gsaurabhr/watchy-sports-hardware/README.md

# watchy-hardware
Watchy Hardware CAD Files
