gsaurabhr/watchy-sports-hardware/watchy-sports-lcsc-jlcpcb-bom.xlsx

Reference | Quantity | Value | Footprint | LCSC | MPN | LCSC Alt | Manufacturer_Name | Mouser Part Number
C1 C2 C4 C5 C8 C10 C11 C13 C14 | 9 | 100nF | Capacitor_SMD:C_0603_1608Metric
C12 | 1 | 4.7uF/50V | Capacitors_SMD:C_0805
C3 | 1 | 1uF | Capacitor_SMD:C_0603_1608Metric
C6 C7 | 2 | 220nF | Capacitor_SMD:C_0603_1608Metric
C9 | 1 | 10uF/50V | Capacitor_SMD:C_0805_2012Metric
D4 | 1 | MBR0530 | Diodes_SMD:D_SOD-123 | C77336 | MBR0530
D5 | 1 | LED | LEDs:LED_0603 | C2286 | LTST-C190KRKT
D6 | 1 | 1N4001 | Diodes_SMD:D_SOD-123F | C433392 | 1N4001
IC1 | 1 | L76L-M33 | Watchy:L76 | C2649477 | L76L-M33 | C90770 | Quectel | 277-L76-M33
J1 | 1 | 503480-0400 | Watchy:MOLEX_503480-0400 | C563965 | 503480-0400 |  | Molex, LLC
J2 | 1 | Micro USB | Watchy:USB_Micro-B | C91146 | U-F-M5DD-Y-L | C145792
J3 | 1 | Battery | Watchy:1.25T-2PWT (Molex 532610271) | C189700 | 532610271
J4 | 1 | FH33-10S-0.5SH(10) | Watchy:FH3310S05SH10 |  | FH33-10S-0.5SH(10) |  | Hirose | 798-FH3310S0.5SH10
J5 | 1 | U.FL-R-SMT(01) | Watchy:HRS_U.FL-R-SMT(01) | C88374 | U.FL-R-SMT(01) |  | Hirose
Q2 | 1 | UMH3N | TO_SOT_Packages_SMD:SOT-363_SC-70-6 | C62892 | UMH3N
Q4 | 1 | CJ2301 | TO_SOT_Packages_SMD:SOT-23 | C8547 | CJ2301
Q5 | 1 | S8050 | TO_SOT_Packages_SMD:SOT-23 | C2146 | S8050
R1 R4 R5 R6 R7 R9 R10 R14 R15 | 9 | 10K | Resistor_SMD:R_0402_1005Metric
R12 R13 | 2 | 100K | Resistor_SMD:R_0402_1005Metric
R16 R17 | 2 | 1K | Resistor_SMD:R_0402_1005Metric
R2 R3 | 2 | 4.7K | Resistor_SMD:R_0402_1005Metric
R8 | 1 | 3.5K | Resistor_SMD:R_0402_1005Metric
SW1 SW2 SW3 SW4 | 4 | BTN | Watchy:K2-1114SA-A4SW-06 | C136662 | K2-1114SA-A4SW-06
U1 | 1 | ESP32-PICO-D4 | Housings_DFN_QFN:QFN-48-1EP_7x7mm_Pitch0.5mm | C193707 | ESP32-PICO-D4
U10 | 1 | BME280 | Package_LGA:Bosch_LGA-8_2.5x2.5mm_P0.65mm_ClockwisePinNumbering | C92489 | BME280
U2 | 1 | ME6211C33M5G-N | TO_SOT_Packages_SMD:SOT-23-5 | C82942 | ME6211C33M5G-N
U3 | 1 | CP2104 | Housings_DFN_QFN:QFN-24-1EP_4x4mm_Pitch0.5mm | C430013 | CP2104-F03-GM
U4 | 1 | BMA423 | Housings_LGA:LGA-12_2x2mm_Pitch0.5mm | C189517 | BMA423 |  | Bosch Sensortec
U5 | 1 | TP4054 | TO_SOT_Packages_SMD:SOT-23-5 | C32574 | TP4054
U6 | 1 | CAT4004AHU2-GT3 | Watchy:CAT4004AHU2-GT3 | C184239 | CAT4004AHU2-GT3
U7 | 1 | MX25L25645GZN-10G | Package_SON:WSON-8-1EP_6x5mm_P1.27mm_EP3.4x4mm | C2802981 | MX25L25645GZN-10G
U8 | 1 | LTR-303ALS-01 | OptoDevice:Lite-On_LTR-303ALS-01 | C364577 | LTR-303ALS-01
U9 | 1 | IIS2MDCTR | Watchy:IIS2MDCTR | C2655002 | IIS2MDCTR
Y1 | 1 | RV-8523-C3-TA-QC-020 | Watchy:RV8523C3TAQC020 |  | RV-8523-C3-TA-QC-020 |  | Micro Crystal AG | N/A
