gsaurabhr/watchy-sports-hardware/watchy-sports-info.xlsx

Sheet: Pin map
ESP32 GPIO | Input | Output | Notes | Buttons | BMA423 | BME280 | Analog / Battery | LCD | IIS2MDC | VIB | Flash memory | RV-8523-C3 | GPS | SP32-PICO-D4 | GDEH0154D67 | BMA423 | DS3231 | Battery ADC | UART | Buttons
0 | pulled up | OK | Strapping pin! 1 for SPI, 0 for downloading firmware, RTC
1 | TX | OK | debug output at boot, HIGH on boot |  |  |  |  |  |  |  |  |  |  | GPIO 1 |  |  |  |  | TX
2 | OK | OK | Strapping pin! Must be 0 for downloading firmware, anything for SPI FLASH Boot, RTC |  |  |  |  |  |  | VIB_PWM
3 | OK | RX | HIGH at boot |  |  |  |  |  |  |  |  |  |  | GPIO 3 |  |  |  |  | RX
4 | OK | OK | RTC | Button 4 |  |  |  |  |  |  |  |  |  | GPIO 4 |  |  |  |  |  | Button 4
5 | OK | OK | Strapping pin! Must be pull up at boot, VSPI_CS |  |  |  |  | LCD_CS |  |  |  |  |  | GPIO 5 | CS
6 | x | x | connected to the integrated SPI flash
7 | x | x | connected to the integrated SPI flash
8 | x | x | connected to the integrated SPI flash
9 | OK | OK | U1RXD |  |  |  |  | LCD_EN |  |  |  |  |  | GPIO 9 | RES
10 | OK | OK | U1TXD |  |  |  |  | BL_PWM |  |  |  |  |  | GPIO 10 | DC
11 | x | x | connected to the integrated SPI flash
12 | OK | OK | Strapping pin! MUST BE PULLED DOWN AT BOOT, HSPI_MISO, RTC |  |  |  |  |  |  |  | FLASH_MISO |  |  | GPIO 12 |  | INT2
13 | OK | OK | HSPI_MOSI, RTC |  |  |  |  |  |  |  | FLASH_MOSI |  |  | GPIO 13
14 | OK | OK | outputs PWM signal at boot, HIGH on boot, HSPI_CLK, RTC |  |  |  |  |  |  |  | FLASH_CLK |  |  | GPIO 14 |  | INT1
15 | OK | OK | Strapping pin! Pulled high to output debugging log during boot, HSPI_CS, RTC |  |  |  |  |  |  |  | FLASH_CS
16 | x | x | connected to the integrated SPI flash
17 | x | x | connected to the integrated SPI flash
18 | OK | OK | VSPI_CLK |  |  |  |  | LCD_CLK |  |  |  |  |  | GPIO 18 | SCLK
19 | OK | OK | VSPI_MISO |  |  |  |  |  |  |  |  |  | FORCEON | GPIO 19 | BUSY
21 | OK | OK | SDA |  | SDA | SDA |  |  | SDA |  |  | SDA | SDA | GPIO 21 |  | SDA | SDA
22 | OK | OK | SCL |  | SCL | SCL |  |  | SCL |  |  | SCL | SCL | GPIO 22 |  | SCL | SCL
23 | OK | OK | VSPI_MOSI |  |  |  |  | LCD_MOSI |  |  |  |  |  | GPIO 23 | MOSI
25 | OK | OK | DAC1, RTC |  | INT_ACC1 |  |  |  |  |  |  |  |  | GPIO 25 |  |  |  |  |  | Button 2
26 | OK | OK | DAC2, RTC |  |  |  |  |  |  |  |  | INT_RTC |  | GPIO 26 |  |  |  |  |  | Button 1
27 | OK | OK | RTC | Button 2 |  |  |  |  |  |  |  |  |  | GPIO 27 |  |  | INT
32 | OK | OK | ADC1, RTC | Button 3 |  |  |  |  |  |  |  |  |  | GPIO 32 |  |  |  |  |  | Button 3
33 | OK | OK | ADC1, RTC |  | INT_ACC2 |  |  |  |  |  |  |  |  | GPIO 33 |  |  |  | ADC
34 | OK |  | input only, ADC1, RTC | Button 1
35 | OK |  | input only, ADC1, RTC |  |  |  | ADC
36 | OK |  | input only, ADC1, RTC
37 | OK |  | input only, ADC1, RTC
38 | OK |  | input only, ADC1, RTC
39 | OK |  | input only, ADC1, RTC
 |  |  |  |  |  |  |  | EXTCOMM |  |  |  | CLK_OUT
 |  |  |  |  |  |  |  | POWER? | INT |  | WP | INT2 | PPS
 |  |  |  |  |  |  |  |  |  |  | RESET |  | STANDBY
 |  |  |  |  |  |  |  |  |  |  | HOLD |  | RESET
 |  |  |  |  |  |  |  |  |  |  |  |  | ANTON

Sheet: Components used
Function | Part | Datasheet | Reference hardware | Reference Software
GPS | L76-L (Quectel) | file:///C:/Users/saurabh.gandhi/Seafile/Activities/Making/watchy-hardware/Quectel_L76_Series_Hardware_Design_V3.1.pdf | https://github.com/StuartsProjects/Devices/tree/master/L70%20L76%20GPS%20Breakout
Display | LPM013M126C | https://static6.arrow.com/aropdfconversion/e8ca7eba36c05d4e31b522c08c2828cf0f2888c4/5lpm013m126c_specification_ver03.pdf
Accl/Mag | IIS2MDCTR
Flash memory | MX25L25645GZN-10G

Sheet: BoM
Reference | Quantity | Value | Footprint | LCSC | MPN | LCSC Alt | Manufacturer_Name | Comment
C1 C2 C4 C5 C8 C10 C11 C13 C14 | 9 | 100nF | Capacitor_SMD:C_0603_1608Metric
C12 | 1 | 4.7uF/50V | Capacitors_SMD:C_0805
C3 | 1 | 1uF | Capacitor_SMD:C_0603_1608Metric
C6 C7 | 2 | 220nF | Capacitor_SMD:C_0603_1608Metric
C9 | 1 | 10uF/50V | Capacitor_SMD:C_0805_2012Metric
D4 | 1 | MBR0530 | Diodes_SMD:D_SOD-123 | C77336 | MBR0530
D5 | 1 | LED | LEDs:LED_0603 | C2286 | LTST-C190KRKT
D6 | 1 | 1N4001 | Diodes_SMD:D_SOD-123F | C433392 | 1N4001
IC1 | 1 | L76L-M33 | Watchy:L76 | C2649477 | L76L-M33 | C90770 | Quectel | TESEO-LIV3F - alternate part
J1 | 1 | 503480-0400 | Watchy:MOLEX_503480-0400 | C563965 | 503480-0400 |  | Molex, LLC
J2 | 1 | Micro USB | Watchy:USB_Micro-B | C91146 | U-F-M5DD-Y-L | C145792
J3 | 1 | Battery | Watchy:1.25T-2PWT (Molex 532610271) | C189700 | 532610271
J4 | 1 | FH33-10S-0.5SH(10) | Watchy:FH3310S05SH10 |  | FH33-10S-0.5SH(10) |  | Hirose
J5 | 1 | U.FL-R-SMT(01) | Watchy:HRS_U.FL-R-SMT(01) | C88374 | U.FL-R-SMT(01) |  | Hirose
Q2 | 1 | UMH3N | TO_SOT_Packages_SMD:SOT-363_SC-70-6 | C62892 | UMH3N
Q4 | 1 | CJ2301 | TO_SOT_Packages_SMD:SOT-23 | C8547 | CJ2301
Q5 | 1 | S8050 | TO_SOT_Packages_SMD:SOT-23 | C2146 | S8050
R1 R4 R5 R6 R7 R9 R10 R14 R15 | 9 | 10K | Resistor_SMD:R_0402_1005Metric
R12 R13 | 2 | 100K | Resistor_SMD:R_0402_1005Metric
R16 R17 | 2 | 1K | Resistor_SMD:R_0402_1005Metric
R2 R3 | 2 | 4.7K | Resistor_SMD:R_0402_1005Metric
R8 | 1 | 3.5K | Resistor_SMD:R_0402_1005Metric
SW1 SW2 SW3 SW4 | 4 | BTN | Watchy:K2-1114SA-A4SW-06 | C136662 | K2-1114SA-A4SW-06
U1 | 1 | ESP32-PICO-D4 | Housings_DFN_QFN:QFN-48-1EP_7x7mm_Pitch0.5mm | C193707 | ESP32-PICO-D4
U10 | 1 | BME280 | Package_LGA:Bosch_LGA-8_2.5x2.5mm_P0.65mm_ClockwisePinNumbering | C92489 | BME280
U2 | 1 | ME6211C33M5G-N | TO_SOT_Packages_SMD:SOT-23-5 | C82942 | ME6211C33M5G-N
U3 | 1 | CP2104 | Housings_DFN_QFN:QFN-24-1EP_4x4mm_Pitch0.5mm | C430013 | CP2104-F03-GM
U4 | 1 | BMA423 | Housings_LGA:LGA-12_2x2mm_Pitch0.5mm | C189517 | BMA423 |  | Bosch Sensortec
U5 | 1 | TP4054 | TO_SOT_Packages_SMD:SOT-23-5 | C32574 | TP4054
U6 | 1 | CAT4004AHU2-GT3 | Watchy:CAT4004AHU2-GT3 | C184239 | CAT4004AHU2-GT3
U7 | 1 | MX25L25645GZN-10G | Package_SON:WSON-8-1EP_6x5mm_P1.27mm_EP3.4x4mm | C2802981 | MX25L25645GZN-10G
U8 | 1 | LTR-303ALS-01 | OptoDevice:Lite-On_LTR-303ALS-01 | C364577 | LTR-303ALS-01
U9 | 1 | IIS2MDCTR | Watchy:IIS2MDCTR | C2655002 | IIS2MDCTR
Y1 | 1 | RV-8523-C3-TA-QC-020 | Watchy:RV8523C3TAQC020 |  | RV-8523-C3-TA-QC-020 |  | Micro Crystal AG

Sheet: Pos
Designation | Val | Package | Mid X | Mid Y | Rotation | Layer
R9 | 10K | R_0402_1005Metric | 23.4180 | 38.2040 | 270.0000 | bottom
SW1 | BTN | K2-1114SA-A4SW-06 | 29.3960 | 36.1860 | 90.0000 | bottom
SW2 | BTN | K2-1114SA-A4SW-06 | 1.7560 | 22.9860 | 270.0000 | bottom
SW3 | BTN | K2-1114SA-A4SW-06 | 1.7560 | 36.1860 | 270.0000 | bottom
SW4 | BTN | K2-1114SA-A4SW-06 | 1.7560 | 9.7860 | 270.0000 | bottom
U8 | LTR-303ALS-01 | Lite-On_LTR-303ALS-01 | 21.6290 | 38.7430 | 90.0000 | bottom
C1 | 100nF | C_0603_1608Metric | 12.8260 | 35.7060 | 90.0000 | top
C2 | 100nF | C_0603_1608Metric | 21.0160 | 7.2860 | 270.0000 | top
C3 | 1uF | C_0603_1608Metric | 9.2160 | 7.1360 | 0.0000 | top
C4 | 100nF | C_0603_1608Metric | 9.2160 | 8.7060 | 0.0000 | top
C5 | 100nF | C_0603_1608Metric | 29.0260 | 12.8060 | 0.0000 | top
C6 | 220nF | C_0603_1608Metric | 22.8260 | 28.9060 | 0.0000 | top
C7 | 220nF | C_0603_1608Metric | 24.6260 | 30.7060 | 270.0000 | top
C8 | 100nF | C_0603_1608Metric | 22.3850 | 15.0870 | 90.0000 | top
C9 | 10uF/50V | C_0805_2012Metric | 20.5930 | 15.3060 | 90.0000 | top
C10 | 100nF | C_0603_1608Metric | 10.6610 | 36.7350 | 0.0000 | top
C11 | 100nF | C_0603_1608Metric | 19.1360 | 23.4260 | 0.0000 | top
C12 | 4.7uF/50V | C_0805 | 15.3190 | 36.0740 | 180.0000 | top
C13 | 100nF | C_0603_1608Metric | 6.5440 | 20.5470 | 90.0000 | top
C14 | 100nF | C_0603_1608Metric | 2.5860 | 37.7160 | 0.0000 | top
D4 | MBR0530 | D_SOD-123 | 24.6960 | 19.2860 | 90.0000 | top
D5 | LED | LED_0603 | 30.4660 | 30.5360 | 90.0000 | top
D6 | 1N4001 | D_SOD-123F | 2.3360 | 34.7110 | 270.0000 | top
IC1 | L76L-M33 | L76 | 13.6260 | 14.5060 | 0.0000 | top
J1 | 503480-0400 | MOLEX_503480-0400 | 25.0760 | 9.6160 | 0.0000 | top
J2 | Micro_USB | USB_Micro-B | 28.8060 | 22.4360 | 90.0000 | top
J3 | Battery | 1.25T-2PWT_(Molex_532610271) | 25.6260 | 36.3060 | 0.0000 | top
J4 | FH33-10S-0.5SH(10) | FH3310S05SH10 | 15.5760 | 5.8060 | 0.0000 | top
J5 | U.FL-R-SMT(01) | HRS_U.FL-R-SMT(01) | 21.0260 | 11.2160 | 270.0000 | top
Q2 | UMH3N | SOT-363_SC-70-6 | 18.7360 | 21.4760 | 180.0000 | top
Q4 | CJ2301 | SOT-23 | 25.8760 | 15.2360 | 270.0000 | top
Q5 | S8050 | SOT-23 | 5.2360 | 35.3160 | 180.0000 | top
R1 | 10K | R_0402_1005Metric | 14.5260 | 34.6060 | 180.0000 | top
R2 | 4.7K | R_0402_1005Metric | 19.4210 | 35.3610 | 0.0000 | top
R3 | 4.7K | R_0402_1005Metric | 18.7240 | 34.2350 | 180.0000 | top
R4 | 10K | R_0402_1005Metric | 29.8260 | 33.3060 | 180.0000 | top
R5 | 10K | R_0402_1005Metric | 1.4110 | 19.7510 | 0.0000 | top
R6 | 10K | R_0402_1005Metric | 4.1160 | 32.6860 | 270.0000 | top
R7 | 10K | R_0402_1005Metric | 4.6260 | 31.1060 | 0.0000 | top
R8 | 3.5K | R_0402_1005Metric | 22.3360 | 6.7360 | 90.0000 | top
R10 | 10K | R_0402_1005Metric | 1.4260 | 6.8060 | 0.0000 | top
R12 | 100K | R_0402_1005Metric | 29.1260 | 28.2860 | 90.0000 | top
R13 | 100K | R_0402_1005Metric | 28.2260 | 28.2860 | 90.0000 | top
R14 | 10K | R_0402_1005Metric | 26.7460 | 17.4060 | 180.0000 | top
R15 | 10K | R_0402_1005Metric | 26.4760 | 13.0760 | 0.0000 | top
R16 | 1K | R_0402_1005Metric | 30.6660 | 28.2860 | 270.0000 | top
R17 | 1K | R_0402_1005Metric | 5.1760 | 32.6860 | 270.0000 | top
U1 | ESP32-PICO-D4 | QFN-48-1EP_7x7mm_Pitch0.5mm | 15.1997 | 29.6647 | 270.0000 | top
U2 | ME6211C33M5G-N | SOT-23-5 | 22.0860 | 19.8860 | 270.0000 | top
U3 | CP2104 | QFN-24-1EP_4x4mm_Pitch0.5mm | 23.1860 | 24.3860 | 0.0000 | top
U4 | BMA423 | LGA-12_2x2mm_Pitch0.5mm | 8.1860 | 34.8960 | 180.0000 | top
U5 | TP4054 | SOT-23-5 | 29.4260 | 15.9360 | 270.0000 | top
U6 | CAT4004AHU2-GT3 | CAT4004AHU2-GT3 | 29.3040 | 5.9550 | 180.0000 | top
U7 | MX25L25645GZN-10G | WSON-8-1EP_6x5mm_P1.27mm_EP3.4x4mm | 3.8260 | 16.4060 | 0.0000 | top
U9 | IIS2MDCTR | IIS2MDCTR | 22.3260 | 31.2060 | 0.0000 | top
U10 | BME280 | Bosch_LGA-8_2.5x2.5mm_P0.65mm_ClockwisePinNumbering | 29.7260 | 40.2060 | 180.0000 | top
Y1 | RV-8523-C3-TA-QC-020 | RV8523C3TAQC020 | 8.4260 | 31.1060 | 270.0000 | top
