gsaurabhr/watchy-sports-hardware/3D/LTR-303ALS-01_LTO.step

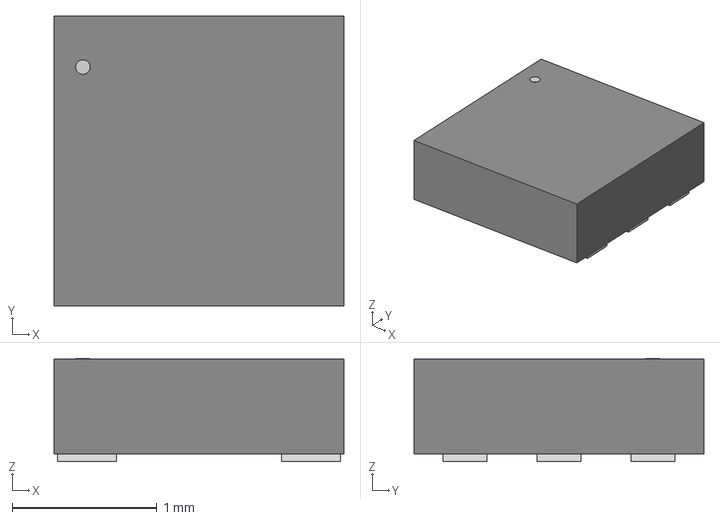
[picture p1: CAD file, 2021-06-02]
3D/LTR-303ALS-01_LTO.step
2.01 x 2.01 x 0.714 mm
