gsaurabhr/watchy-sports-hardware/3D/UDFN8_2X2_ONS.step

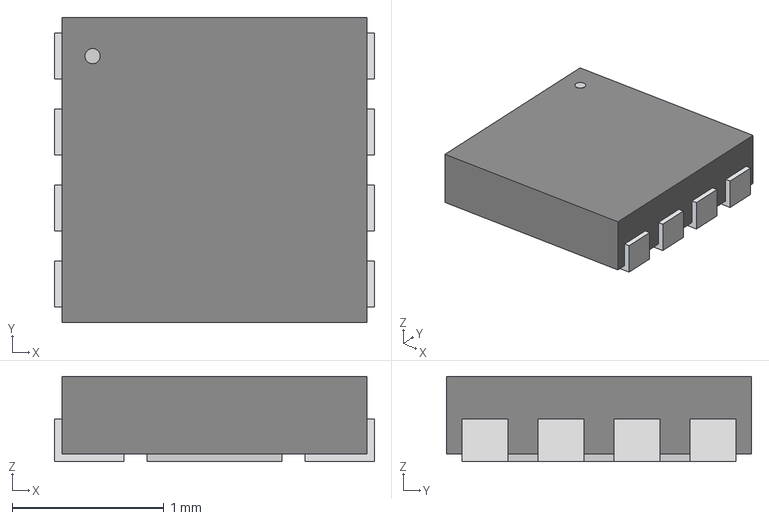
[picture p2: CAD file, 2021-06-02]
3D/UDFN8_2X2_ONS.step
2.11 x 2.01 x 0.561 mm
