gsaurabhr/watchy-sports-hardware/3D/U.FL-R-SMT_01_.step

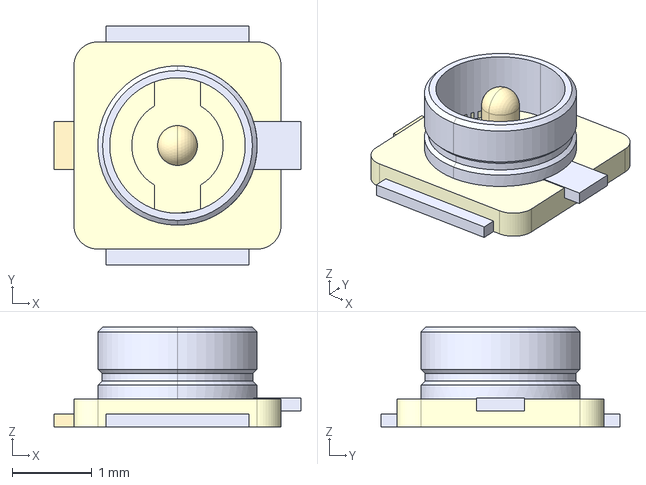
[picture p3: CAD file, 2021-06-02]
3D/U.FL-R-SMT_01_.step
3.10 x 3.00 x 1.25 mm
