gsaurabhr/watchy-sports-hardware/3D/MIC-VFDFPN-8_8X6_MRN.step

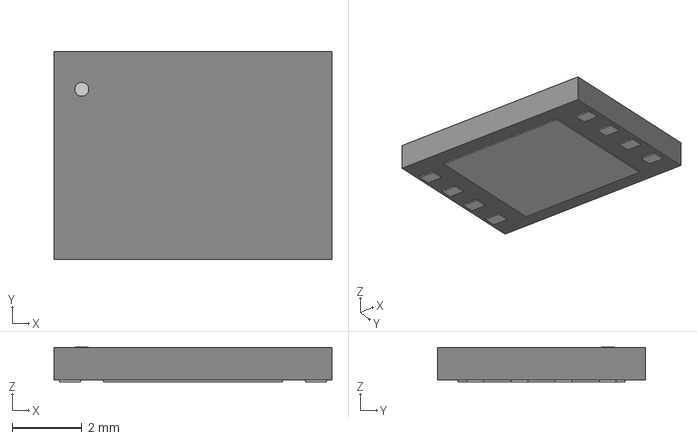
[picture p4: CAD file, 2021-04-25]
3D/MIC-VFDFPN-8_8X6_MRN.step
8.00 x 5.99 x 0.993 mm
