gsaurabhr/watchy-sports-hardware/3D/LGA-12_2X2X0P7_STM.step

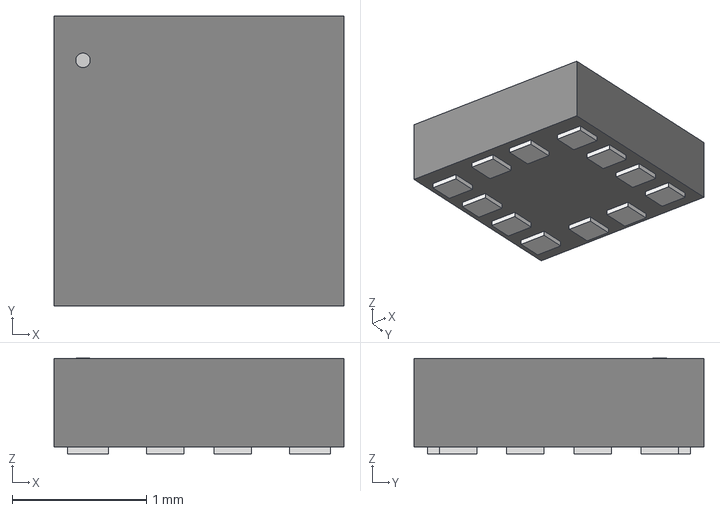
[picture p5: CAD file, 2021-04-25]
3D/LGA-12_2X2X0P7_STM.step
2.16 x 2.16 x 0.714 mm
