gsaurabhr/watchy-sports-hardware/3D/FH33-10S-0.5SH_10_.stp

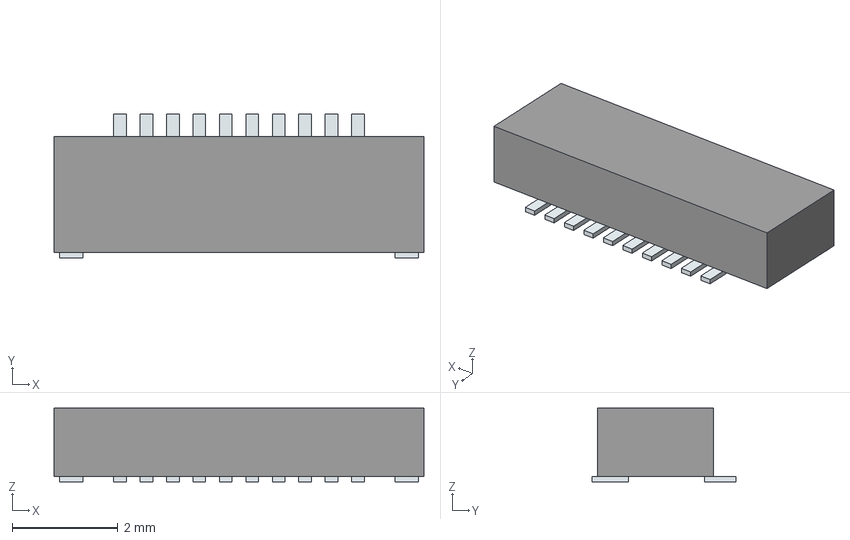
[picture p6: CAD file, 2021-04-25]
3D/FH33-10S-0.5SH_10_.stp
7.00 x 2.72 x 1.40 mm
Pins
