gsaurabhr/watchy-sports-hardware/3D/RV-8523-C3-TA-QC-020.stp

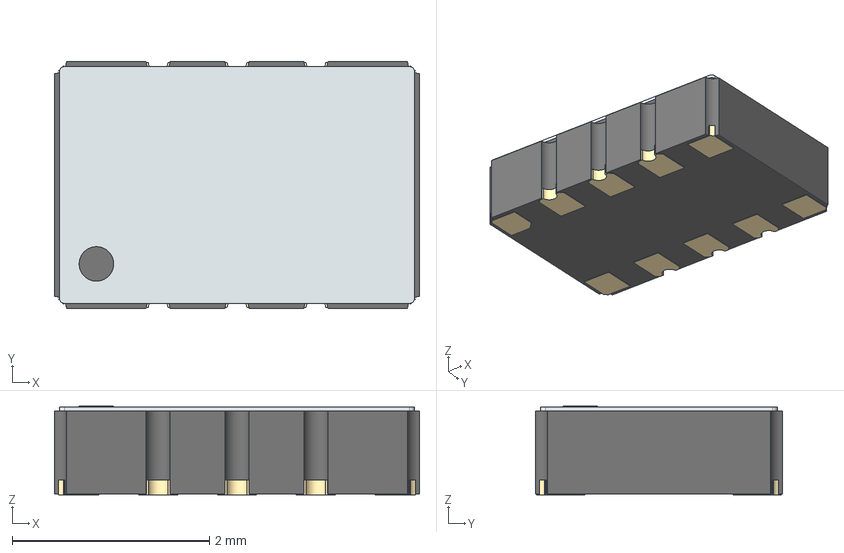
[picture p7: CAD file, 2021-04-25]
3D/RV-8523-C3-TA-QC-020.stp
3.70 x 2.50 x 0.9 mm
Terminal
