gsaurabhr/watchy-sports-hardware/3D/503480-0400.step

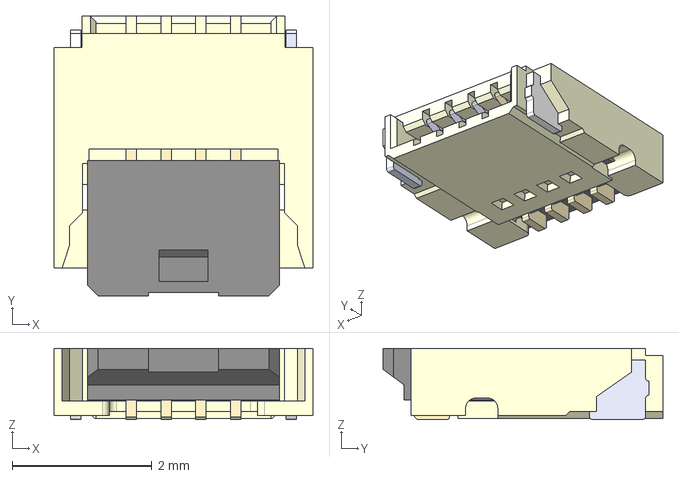
[picture p8: CAD file, 2021-04-25]
3D/503480-0400.step
3.70 x 4.00 x 1.02 mm
