gsaurabhr/watchy-sports-hardware/Watchy.kicad_pcb

## KiCad design Watchy.kicad_pcb (2021-07-26)

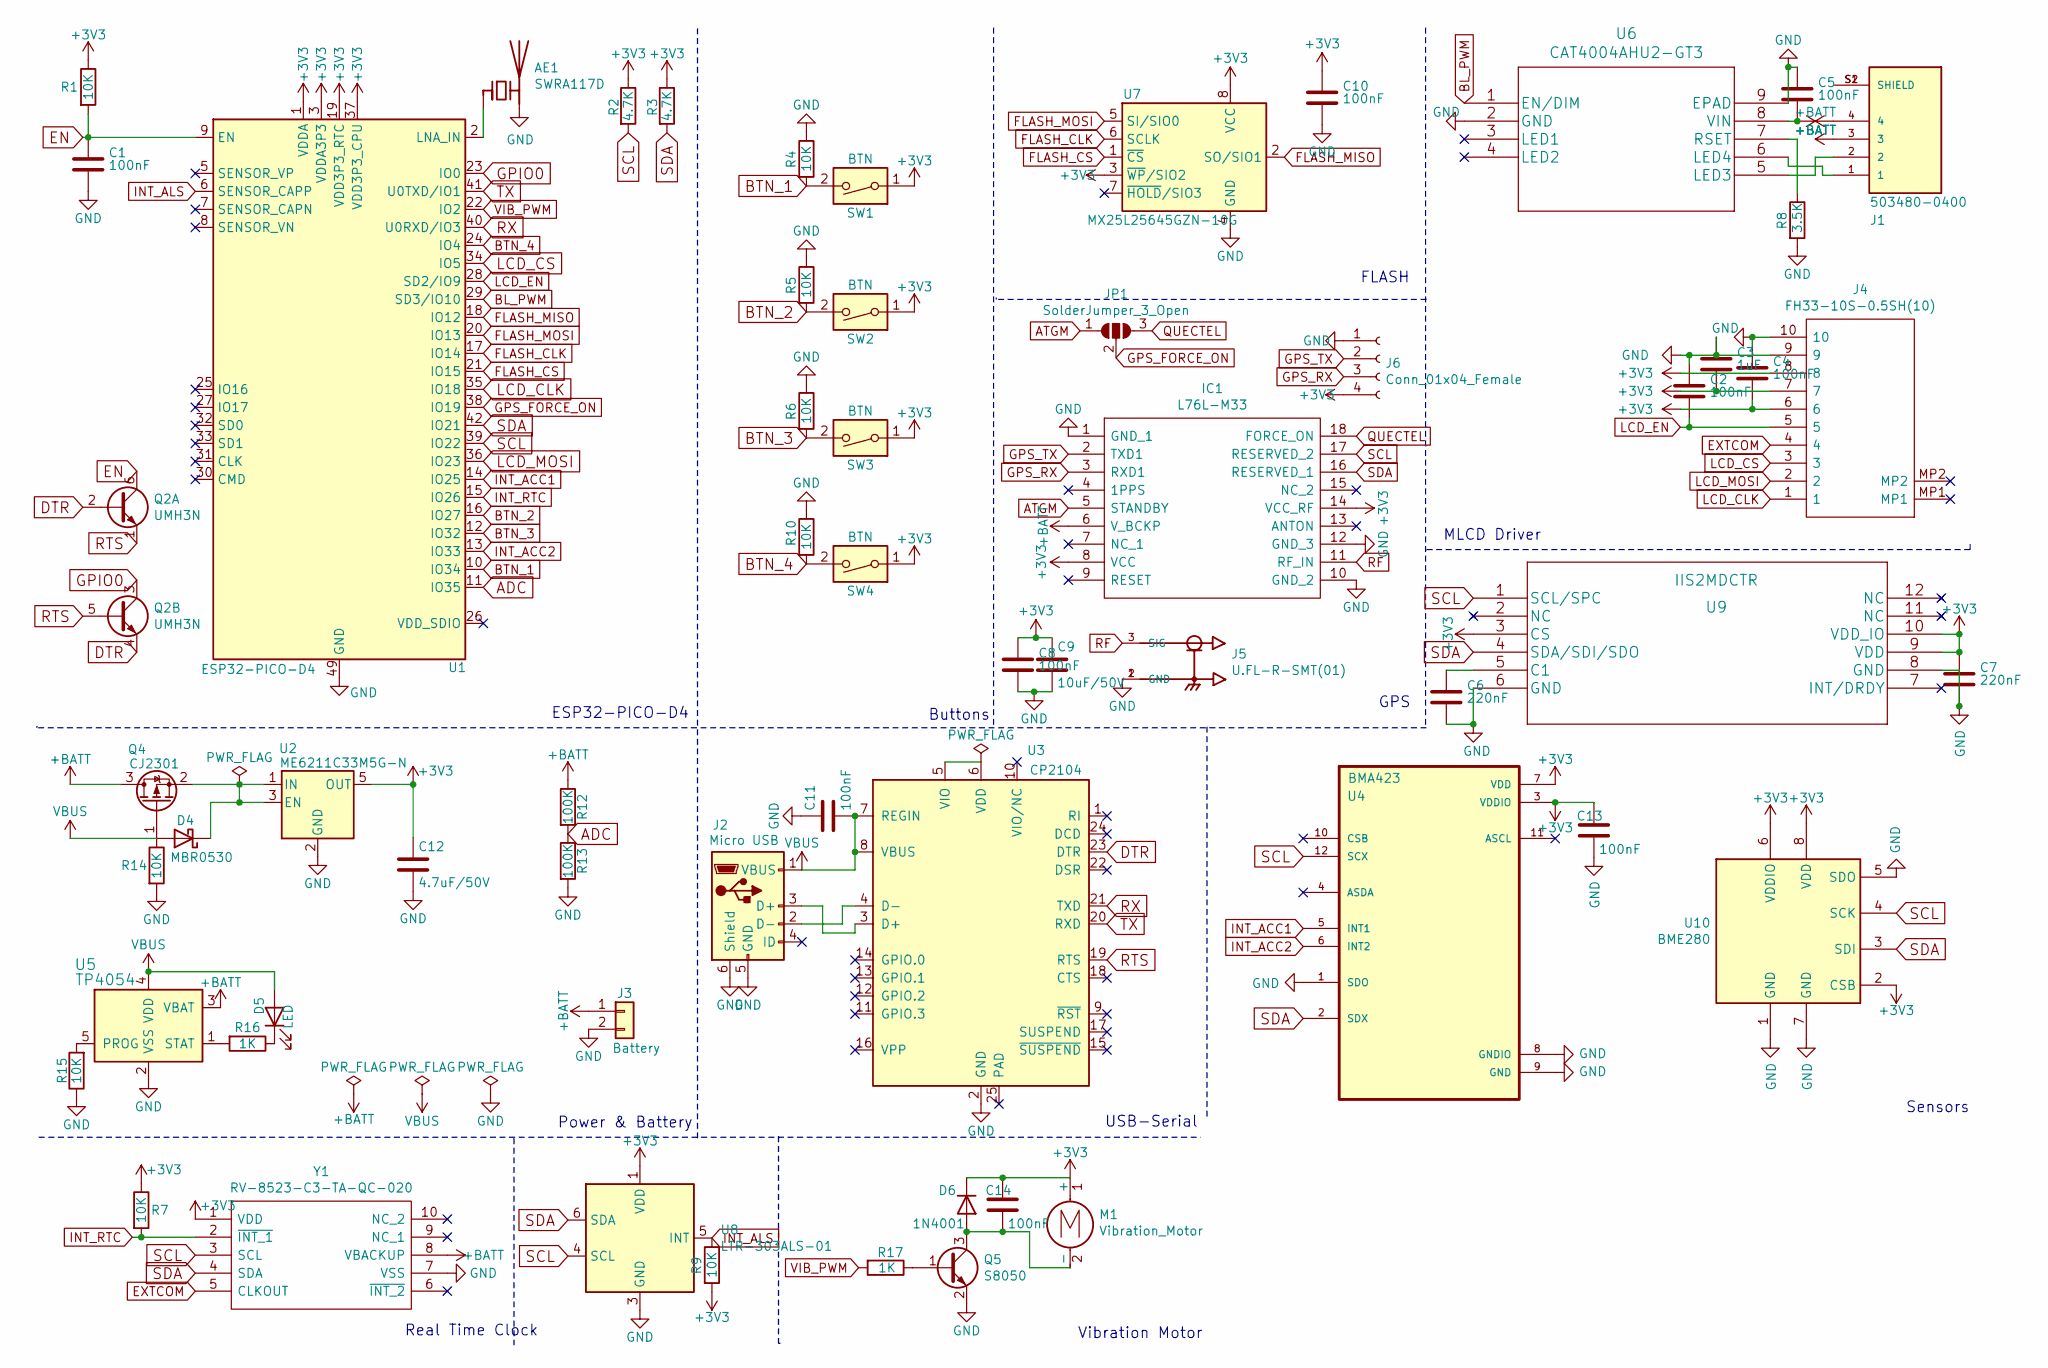
[picture p9: schematic Watchy.sch]

Parts:
AE1: SWRA117D
C1, C2, C4, C5, C8, C10, C11, C13, C14: 100nF; C_0603_1608Metric
C3: 1uF; C_0603_1608Metric
C6, C7: 220nF; C_0603_1608Metric
C9: 10uF/50V; C_0805_2012Metric
C12: 4.7uF/50V; C_0805
D4: MBR0530; D_SOD-123; MPN MBR0530; LCSC C77336
D5: LED; LED_0603; MPN LTST-C190KRKT; LCSC C2286
D6: 1N4001; D_SOD-123F; MPN 1N4001; LCSC C433392
IC1: L76L-M33; L76; Manufacturer_Part_Number L76L-M33; Mouser Part Number 277-L76-M33
J1: 503480-0400; MOLEX_503480-0400; MPN 503480-0400; LCSC C563965
J2: Micro USB; USB_Micro-B; MPN U-F-M5DD-Y-L; LCSC C91146
J3: Battery; 1.25T-2PWT (Molex 532610271); MPN 532610271; LCSC C189700
J4: FH33-10S-0.5SH(10); FH3310S05SH10; MPN FH33-10S-0.5SH(10); Mouser Part Number 798-FH3310S0.5SH10
J5: U.FL-R-SMT(01); HRS_U.FL-R-SMT(01); MPN U.FL-R-SMT(01); LCSC C88374
J6: Conn_01x04_Female; PinSocket_1x04_P1.00mm_Vertical
JP1: SolderJumper_3_Open; SolderJumper-3_P1.3mm_Open_Pad1.0x1.5mm
M1: Vibration_Motor; Motor_Header
Q2: UMH3N; SOT-363_SC-70-6; MPN UMH3N; LCSC C62892
Q4: CJ2301; SOT-23; MPN CJ2301; LCSC C8547
Q5: S8050; SOT-23; MPN S8050; LCSC C2146
R1, R4, R5, R6, R7, R9, R10, R14, R15: 10K; R_0402_1005Metric
R2, R3: 4.7K; R_0402_1005Metric
R8: 3.5K; R_0402_1005Metric
R12, R13: 100K; R_0402_1005Metric
R16, R17: 1K; R_0402_1005Metric
SW1, SW2, SW3, SW4: BTN; K2-1114SA-A4SW-06; MPN K2-1114SA-A4SW-06; LCSC C136662
U1: ESP32-PICO-D4; QFN-48-1EP_7x7mm_Pitch0.5mm; MPN ESP32-PICO-D4; LCSC C193707
U2: ME6211C33M5G-N; SOT-23-5; MPN ME6211C33M5G-N; LCSC C82942
U3: CP2104; QFN-24-1EP_4x4mm_Pitch0.5mm; MPN CP2104-F03-GM; LCSC C430013
U4: BMA423; LGA-12_2x2mm_Pitch0.5mm; MPN BMA423; LCSC C189517
U5: TP4054; SOT-23-5; MPN TP4054; LCSC C32574
U6: CAT4004AHU2-GT3; MPN CAT4004AHU2-GT3; LCSC C184239
U7: MX25L25645GZN-10G; WSON-8-1EP_6x5mm_P1.27mm_EP3.4x4mm; MPN MX25L25645GZN-10G; LCSC C2802981
U8: LTR-303ALS-01; Lite-On_LTR-303ALS-01; MPN LTR-303ALS-01; LCSC C364577
U9: IIS2MDCTR; MPN IIS2MDCTR; LCSC C2655002
U10: BME280; Bosch_LGA-8_2.5x2.5mm_P0.65mm_ClockwisePinNumbering; MPN BME280; LCSC C92489
Y1: RV-8523-C3-TA-QC-020; RV8523C3TAQC020; MPN RV-8523-C3-TA-QC-020; Mouser Part Number N/A

Connections:
+3V3: C3.2, C4.2, C7.1, C8.1, C9.1, C10.1, C12.1, C13.1, C14.1, D6.1 (K), IC1.8 (VCC), IC1.14 (VCC_RF), J4.6, J4.7, J4.8, J6.4, M1.1 (+), R1.1, R2.1, R3.1, R7.1, R9.2, SW1.1, SW2.1, SW3.1, SW4.1, U1.1 (VDDA), U1.3 (VDDA3P3), U1.4 (VDDA3P3), U1.19 (VDD3P3_RTC), U1.37 (VDD3P3_CPU), U1.43 (VDDA), U1.46 (VDDA), U2.5 (OUT), U4.3 (VDDIO), U4.7 (VDD), U7.3 (~WP~/SIO2), U7.8 (VCC), U8.1 (VDD), U9.3 (CS), U9.9 (VDD), U9.10 (VDD_IO), U10.2 (CSB), U10.6 (VDDIO), U10.8 (VDD), Y1.1 (VDD)
+BATT: C5.2, IC1.6 (V_BCKP), J1.3, J1.4, J3.1, Q4.3 (D), R12.1, U5.3 (VBAT), U6.8 (VIN), Y1.8 (VBACKUP)
ADC: R12.2, R13.1, U1.11 (IO35)
ATGM: IC1.5 (STANDBY), JP1.1 (A)
BL_PWM: U1.29 (SD3/IO10), U6.1 (EN/DIM)
BTN_1: R4.2, SW1.2, U1.10 (IO34)
BTN_2: R5.2, SW2.2, U1.16 (IO27)
BTN_3: R6.2, SW3.2, U1.12 (IO32)
BTN_4: R10.2, SW4.2, U1.24 (IO4)
DTR: Q2.2 (B1), Q2.4 (E2), U3.23 (DTR)
EN: C1.1, Q2.6 (C1), R1.2, U1.9 (EN)
EXTCOM: J4.4, Y1.5 (CLKOUT)
FLASH_CLK: U1.17 (IO14), U7.6 (SCLK)
FLASH_CS: U1.21 (IO15), U7.1 (~CS)
FLASH_MISO: U1.18 (IO12), U7.2 (SO/SIO1)
FLASH_MOSI: U1.20 (IO13), U7.5 (SI/SIO0)
GND: AE1.2 (PCB_Trace), C1.2, C2.1, C3.1, C4.1, C5.1, C6.2, C7.2, C8.2, C9.2, C10.2, C11.1, C12.2, C13.2, IC1.1 (GND_1), IC1.10 (GND_2), IC1.12 (GND_3), J2.5 (GND), J2.6 (Shield), J3.2, J4.9, J4.10, J5.1 (GND), J5.2 (GND), J6.1, Q5.2 (E), R4.1, R5.1, R6.1, R8.2, R10.1, R13.2, R14.2, R15.1, U1.49 (GND), U2.2 (GND), U3.2 (GND), U4.1 (SDO), U4.8 (GNDIO), U4.9 (GND), U5.2 (VSS), U6.2 (GND), U6.9 (EPAD), U7.4 (GND), U7.9 (GND), U8.3 (GND), U9.6 (GND), U9.8 (GND), U10.1 (GND), U10.5 (SDO), U10.7 (GND), Y1.7 (VSS)
GPIO0: Q2.3 (C2), U1.23 (IO0)
GPS_FORCE_ON: JP1.2 (C), U1.38 (IO19)
GPS_RX: IC1.3 (RXD1), J6.3
GPS_TX: IC1.2 (TXD1), J6.2
INT_ACC1: U1.14 (IO25), U4.5 (INT1)
INT_ACC2: U1.13 (IO33), U4.6 (INT2)
INT_ALS: R9.1, U1.6 (SENSOR_CAPP), U8.5 (INT)
INT_RTC: R7.2, U1.15 (IO26), Y1.2 (~INT_1)
LCD_CLK: J4.1, U1.35 (IO18)
LCD_CS: J4.3, U1.34 (IO5)
LCD_EN: C2.2, J4.5, U1.28 (SD2/IO9)
LCD_MOSI: J4.2, U1.36 (IO23)
unnamed: AE1.1 (FEED), U1.2 (LNA_IN)
unnamed: C6.1, U9.5 (C1)
unnamed: C14.2, D6.2 (A), M1.2 (-), Q5.3 (C)
unnamed: D4.1 (K), Q4.2 (S), U2.1 (IN), U2.3 (EN)
unnamed: D5.1 (K), R16.1
unnamed: J1.1, U6.6 (LED4)
unnamed: J1.2, U6.5 (LED3)
unnamed: J1.S1 (SHIELD), J1.S2 (SHIELD)
unnamed: J2.2 (D-), U3.4 (D-)
unnamed: J2.3 (D+), U3.3 (D+)
unnamed: Q5.1 (B), R17.1
unnamed: R8.1, U6.7 (RSET)
unnamed: R15.2, U5.5 (PROG)
unnamed: R16.2, U5.1 (STAT)
unnamed: U3.5 (VIO), U3.6 (VDD)
QUECTEL: IC1.18 (FORCE_ON), JP1.3 (B)
RF: IC1.11 (RF_IN), J5.3 (SIG)
RTS: Q2.1 (E1), Q2.5 (B2), U3.19 (RTS)
RX: U1.40 (U0RXD/IO3), U3.21 (TXD)
SCL: IC1.17 (RESERVED_2), R2.2, U1.39 (IO22), U4.12 (SCX), U8.4 (SCL), U9.1 (SCL/SPC), U10.4 (SCK), Y1.3 (SCL)
SDA: IC1.16 (RESERVED_1), R3.2, U1.42 (IO21), U4.2 (SDX), U8.6 (SDA), U9.4 (SDA/SDI/SDO), U10.3 (SDI), Y1.4 (SDA)
TX: U1.41 (U0TXD/IO1), U3.20 (RXD)
VBUS: C11.2, D4.2 (A), D5.2 (A), J2.1 (VBUS), Q4.1 (G), R14.1, U3.7 (REGIN), U3.8 (VBUS), U5.4 (VDD)
VIB_PWM: R17.2, U1.22 (IO2)

Notes on the sheet:
ESP32-PICO-D4
Power & Battery
Real Time Clock
USB-Serial
Sensors
MLCD Driver
Buttons
Vibration Motor
GPS
FLASH

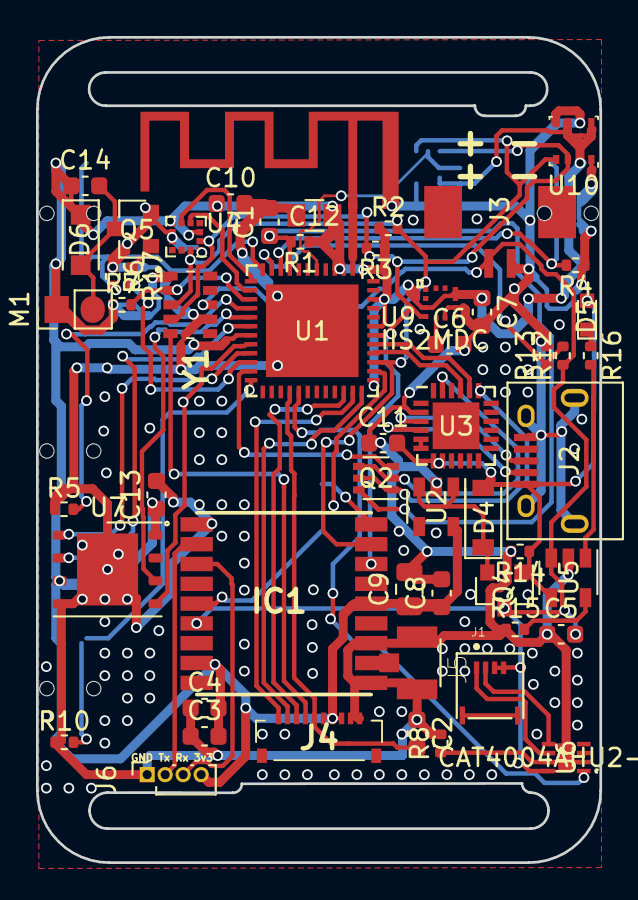
[picture p10: board Watchy.kicad_pcb from above]

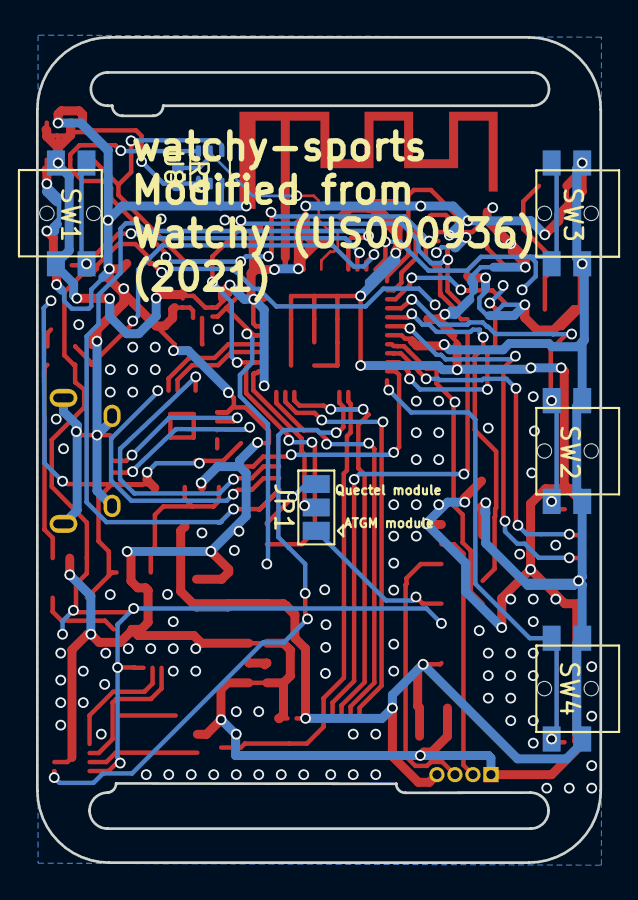
[picture p11: board Watchy.kicad_pcb from below]

Board: 2 copper layers, 31.3 x 45.8 mm, 61 parts (7 on the bottom side), 53 nets.
