gsaurabhr/watchy-sports-hardware/(commit log)

2021-04-25 added or replaced parts and altered borad outline
    [503480-0400.step, FH33-10S-0.5SH_10_.stp, LGA-12_2X2X0P7_STM.step, MIC-VFDFPN-8_8X6_MRN.step, RV-8523-C3-TA-QC-020.stp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]
2021-06-02 version 0 production
    [LTR-303ALS-01_LTO.step, U.FL-R-SMT_01_.step, UDFN8_2X2_ONS.step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]
2021-07-26 v0 PCBWay final version
    [Watchy.kicad_pcb, Watchy.sch]
